sheppardd1/Controls_Final_Project/(commit log)

2019-04-29 added main.c based on Embedded project. Made rough PID (untested)
2019-04-30 added median filter
2019-04-30 added code to read ptat and pot in ADC
2019-05-02 minor updates, added pin number for PWM
2019-05-02 minor code fixes, changed method for assigning ports
    [main.ino]
2019-05-07 added schematic
2019-05-09 added block diagram and fixed schematic
